WPxyz-moon/ESP32HandledConsole/docs/README.md

# 基于 ESP32-S3 的多模态 AI 游戏掌机 — 设计文档

> 版本：v0.1（方案设计稿）  
> 日期：2026-11-03  
> 依据：《手柄实现方案.docx》《选题申请表-周二下午-基于ESP32-S3游戏掌机.docx》  
> 参考项目：[OSHWHub / zistar / ESP32S3多功能手柄](https://oshwhub.com/zistar/project_fhhysqix)、[GitHub / zistar001 / ESP-Handheld](https://github.com/zistar001/ESP-Handheld)

## 文档索引

| 文档 | 内容 | 适合谁看 |
|---|---|---|
| [01-系统框图.md](01-系统框图.md) | 总体架构、硬件框图、软件分层、Flash 分区、引脚分配、关键设计决策 | 全员；硬件与系统负责人重点看 |
| [02-子系统流程图.md](02-子系统流程图.md) | 主系统、AI 子系统、游戏子系统的启动流程、状态机、时序与异常处理 | 软件负责人；联调时对照 |
| [03-项目实现计划.md](03-项目实现计划.md) | 第 5–14 周里程碑、任务分解、三人分工、测试指标、风险与交付物 | 组长与全员 |
| [04-参考项目分析.md](04-参考项目分析.md) | 参考项目拆解、可复用模块、改造点、许可证与已知坑 | 技术负责人；动手前必读 |
| [05-PCB核对与改板建议.md](05-PCB核对与改板建议.md) | 实际 PCB 引脚表、电源树、与参考项目差异、电池采样/保护等硬件风险 | 硬件与系统负责人；焊接/点屏前必读 |

## 一句话架构

**一颗 ESP32-S3 + 三套独立固件**：`factory` 主系统负责菜单、设置、BLE HID、Wi-Fi 音频与电源管理；`ota_0` 游戏系统运行 Retro-Go / nofrendo NES 模拟器；`ota_1` AI 系统运行文本对话、语音对话与图形化 AI 宠物。三套固件通过 `otadata` 切换，切换时重启并清空 RAM，从机制上避免长期运行后的内存碎片与 OOM。

```text
                    ┌──────────────────────────────┐
                    │        ESP32-S3 (N16R8)      │
                    │  8MB PSRAM / 16MB Flash      │
                    │  Wi-Fi 2.4G / BLE 5.0        │
                    └──────────────┬───────────────┘
                                   │
          ┌────────────────────────┼────────────────────────┐
          │                        │                        │
   ┌──────▼──────┐          ┌──────▼──────┐          ┌──────▼──────┐
   │  factory    │          │    ota_0    │          │    ota_1    │
   │  主系统     │          │  游戏系统   │          │  AI 系统    │
   │ 菜单/设置   │          │ Retro-Go    │          │ 文本/语音   │
   │ BLE/Wi-Fi   │          │ NES 模拟器  │          │ AI 宠物     │
   └─────────────┘          └─────────────┘          └─────────────┘
```

## 硬件前提（开工前先确认）

本方案按 **ESP32-S3-WROOM-1U-N16R8（8MB Octal PSRAM + 16MB Flash）** 设计。项目内已有实际 PCB：`Gerber_PCB1_2026-10-27/`；**引脚与连接以该文件夹的数据文件（Gerber / `FlyingProbeTesting.json`）为准**，`硬件设计参考图.png` 只作辅助参考。完整核对见 [05-PCB核对与改板建议.md](05-PCB核对与改板建议.md)。

- [x] 模组：`ESP32-S3-WROOM-1U-N16R8`，16MB Flash / 8MB Octal PSRAM
- [x] 屏幕：ST7789 240×280 SPI（1.69 寸）
- [x] 音频：MSM261 数字麦克风 + MAX98357 数字功放
- [x] 传感器：LSM6DS3TR-C 六轴 IMU
- [x] 存储：microSD（SPI3）
- [x] 按键：8 键，含独立 CTRL（GPIO8）
- [ ] 电池：**必须使用自带保护板的 3.7V 锂电池**（PCB 只有 TP4056 充电，无过放保护）
- [ ] 电量采样：**当前 PCB 无 BAT_ADC / 电量计**，需外挂 I2C 电量计（MAX17048/ADS1115）或改板
- [ ] 充电状态：**TP4056 的 CHRG/STDBY 只接 LED，没有接到 MCU**；软件要显示充电状态需额外引出/电平转换
- [ ] 天线：1U 模组必须外接 IPEX 2.4G 天线

> **重要**：当前 PCB 没有电池电压采样。未补装电量计前，“电量百分比、低电保护、电量误差 <5%”无法验收。处理方案见 [05 §6](05-PCB核对与改板建议.md#p0-1--没有电池电压采样--电量计)。
>
> 如果手上是经典 ESP32（非 S3）或没有 8MB PSRAM，本方案的“三固件 + LVGL + NES + 语音”需要降级：优先保留单固件主系统 + NES，AI 与三固件作为选做。具体裁剪见 [03-项目实现计划.md](03-项目实现计划.md)。

## 方案边界

**要做**：LVGL 图形界面、NES 模拟器、AI 文本助手、图形化 AI 宠物（按键/重力/语音）、Wi-Fi 音频、BLE 键盘/手柄、三固件切换、电源管理、数字音频系统、Ctrl 键与键盘映射。

**不做**（按《手柄实现方案》）：天气、占卜、频谱分析仪；参考项目中的音乐/视频播放器也不在本次范围。

## 需求覆盖矩阵

| 《手柄实现方案》要求 | 落地位置 |
|---|---|
| NES 模拟器 | [02-子系统流程图 §3](02-子系统流程图.md#3-游戏子系统ota_0) |
| AI 语言助手（文本输入） | [02-子系统流程图 §2.2](02-子系统流程图.md#22-文本对话时序) |
| 图形化 AI 小助手（按键/重力/音频） | [02-子系统流程图 §2.4–2.5](02-子系统流程图.md#24-图形化-ai-宠物状态机) |
| Wi-Fi 音频（语音传主机） | [01-系统框图 §6](01-系统框图.md#6-关键数据流) |
| 游戏下载 | [02-子系统流程图 §1.6](02-子系统流程图.md#16-wi-fi-游戏资源下载) |
| LVGL 图形界面 | [01-系统框图 §3](01-系统框图.md#3-软件分层框图) |
| 三固件切换 | [01-系统框图 §4](01-系统框图.md#4-flash-分区与三固件切换) |
| 电源管理（电量/低电保护） | [01-系统框图 §7.6](01-系统框图.md#76-电源与低电保护依赖外挂电量计) / [05 §6](05-PCB核对与改板建议.md#p0-1--没有电池电压采样--电量计) |
| 音频系统（数字麦/功放） | [01-系统框图 §5.3](01-系统框图.md#53-音频i2s) |
| 键盘（Ctrl + 方向键映射） | [01-系统框图 §7.3](01-系统框图.md#73-键盘映射) |
| BLE 蓝牙手柄 | [02-子系统流程图 §1.5](02-子系统流程图.md#15-主系统功能入口) |
| 性能/成本指标 | [03-项目实现计划 §3 第14周](03-项目实现计划.md#第-14-周联调与验收) |

## 阅读顺序建议

1. 先看 [05-PCB核对与改板建议.md](05-PCB核对与改板建议.md)，确认实际引脚、电源与电池采样风险。
2. 再看 [04-参考项目分析.md](04-参考项目分析.md) 了解参考项目能给我们什么、不能照搬什么。
3. 再看 [01-系统框图.md](01-系统框图.md) 确认硬件接口与分区。
4. 软件同学看 [02-子系统流程图.md](02-子系统流程图.md) 认领模块。
5. 最后按 [03-项目实现计划.md](03-项目实现计划.md) 排期与验收。

## 文档约定

- 图中的引脚编号以 `Gerber_PCB1_2026-10-27/` 的实际数据文件为准；`硬件设计参考图.png` 仅辅助理解，不作为连接依据。参考项目 Rev2 的分配只用于解释“为什么这样改”。
- 所有流程图使用 Mermaid 编写，GitHub、GitLab、支持 Mermaid 的 Markdown 预览可直接渲染。VS Code 若看不到图，可安装 “Markdown Preview Mermaid Support” 扩展，或把文档推到 GitHub 查看。
- 图中“主系统 / 游戏系统 / AI 系统”均指独立固件，不是同一固件内的三个页面。
