WPxyz-moon/ESP32HandledConsole/docs/01-系统框图.md

# 01 · 系统框图

> 对应《手柄实现方案》与《选题申请表》中的“系统总体方案与硬件设计”“双固件分区规划”。  
> 目标：在单块 ESP32-S3 上，用三套独立固件承载主系统、游戏系统与 AI 系统，并共用一套板级驱动源码。

> **硬件基线（2026-11-03 更新）**：本文引脚以 `Gerber_PCB1_2026-10-27/` 的实际数据文件为准，模组为 `ESP32-S3-WROOM-1U-N16R8`。完整核对、差异与风险见 [05-PCB核对与改板建议.md](05-PCB核对与改板建议.md)。当前 PCB **没有电池电压采样/电量计**，电量显示与低电保护需外挂 I2C 电量计或改板后才能验收。

## 1. 设计目标

| 维度 | 目标 |
|---|---|
| 主控 | ESP32-S3-WROOM-1U-N16R8，双核 Xtensa LX7，最高 240 MHz |
| 存储 | 8MB Octal PSRAM + 16MB Flash |
| 显示 | ST7789 240×280 SPI 彩屏，LVGL v8.4 |
| 输入 | 8 键：UP / DOWN / LEFT / RIGHT / A / B / START / CTRL（CTRL=GPIO8） |
| 音频 | MSM261 数字麦克风（I2S RX）+ MAX98357 数字功放（I2S TX） |
| 传感 | LSM6DS3TR-C 六轴 IMU；AHT20 温湿度（可选，需外挂） |
| 存储 | microSD（ROM / 资源 / 存档，SPI3；无卡检测脚） |
| 无线 | Wi-Fi 2.4GHz（云端 AI、UDP 音频、资源下载）；BLE 5.0（HID 键盘/手柄） |
| 电源 | 带保护板锂电池 + TP4056 充电 + 自动切换 + SY8088 3.3V；**电量采样待补** |
| 系统形态 | `factory` 主系统 / `ota_0` 游戏 / `ota_1` AI，三固件切换 |

## 2. 总体系统框图

系统框图

> 可编辑的矢量图源文件：[系统框图.svg](系统框图.svg)；如需插入 Word/PPT，可用同目录下的 [系统框图.png](系统框图.png)。下图是同一结构的 Mermaid 版本，便于在 GitHub 上直接查看与修改。

```mermaid
flowchart LR
    subgraph PWR["电源子系统"]
        USB["USB-C 5V 输入"]
        CHG["TP4056 充电<br/>（无过放保护）"]
        BAT["3.7V 锂电池<br/>（带保护板）"]
        REG["SY8088 3.3V 降压"]
        GAUGE["I2C 电量计 / ADC<br/>（待补）"]
        USB --> CHG
        CHG <--> BAT
        BAT --> REG
        BAT -.-> GAUGE
    end

    subgraph MCU["ESP32-S3-WROOM-1U-N16R8"]
        CPU["双核 Xtensa LX7<br/>最高 240 MHz"]
        MEM["8 MB Octal PSRAM<br/>16 MB Flash"]
        RF["2.4 GHz Wi-Fi<br/>Bluetooth LE 5.0"]
        IO["SPI / I2S / I2C<br/>GPIO / ADC / PWM"]
        CPU --- MEM
        CPU --- RF
        CPU --- IO
    end

    subgraph HMI["人机交互"]
        LCD["ST7789 240×280<br/>CS42/DC43/BL44"]
        BL["背光 PWM<br/>GPIO44"]
        KEY["8 个按键<br/>UP/DOWN/LEFT/RIGHT<br/>A/B/START/CTRL(8)"]
        IMU["LSM6DS3TR-C<br/>六轴 IMU（无 INT）"]
        AHT["AHT20 温湿度<br/>可选外挂"]
    end

    subgraph AUDIO["音频子系统"]
        MIC["MSM261<br/>I2S 数字麦克风"]
        AMP["MAX98357<br/>I2S 数字功放"]
        SPK["扬声器"]
    end

    subgraph STORAGE["存储"]
        SD["microSD 卡<br/>SPI3（CS38/CLK40）"]
        FLASH["Flash 分区<br/>factory / ota_0 / ota_1 / assets"]
    end

    subgraph CLOUD["网络与上位机"]
        PC["PC / 手机"]
        API["云端 ASR / LLM / TTS"]
    end

    REG -->|"3.3V"| CPU
    GAUGE -.->|"I2C（待补）"| IO
    USB -.->|"USB Serial/JTAG"| CPU
    IO -->|"SPI2 + DMA"| LCD
    IO -->|"PWM"| BL
    KEY -->|"GPIO 中断"| IO
    IMU <-->|"I2C"| IO
    AHT <-->|"I2C"| IO
    MIC -->|"I2S0 RX"| IO
    IO -->|"I2S1 TX"| AMP
    AMP --> SPK
    SD <-->|"SPI3"| IO
    MEM --- FLASH
    RF <-->|"Wi-Fi / HTTPS / WebSocket"| API
    RF <-->|"BLE HID"| PC
    RF <-->|"Wi-Fi UDP"| PC
```

### 框图说明

- **显示与 SD 卡分总线**：ST7789 走 `SPI2_HOST`，SD 卡走 `SPI3_HOST`，避免屏幕 DMA 刷新被 SD 读写阻塞。
- **音频双 I2S**：麦克风走 `I2S0`（RX），功放走 `I2S1`（TX），可同时录音与播放，便于语音对话和“打断”。
- **按键独立 GPIO**：8 个按键全部用 GPIO 上拉 + 低有效，按下产生中断，软件 10–20ms 消抖；CTRL 独立接 GPIO8，不做长按复用。
- **电源采样（待补）**：当前 PCB 没有 BAT_ADC/电量计，TP4056 的 CHRG/STDBY 也只接 LED、没有接到 MCU。需在 I2C 总线上外挂 MAX17048 或 ADS1115+分压，才能做电量显示与低电保护；未补装前只能做运行时间估算。详见 [05 §6](05-PCB核对与改板建议.md#p0-1--没有电池电压采样--电量计)。
- **无线分时**：BLE HID 与 Wi-Fi 不同时高负载使用；游戏手柄模式以 BLE 为主，Wi-Fi 音频模式以 Wi-Fi 为主。
- **显示引脚注意**：本板 `LCD_DC=GPIO43`、`LCD_BL=GPIO44`，与参考项目 Rev2 的 44/43 相反；固件不要照抄参考。

## 3. 软件分层框图

三套固件是**三个独立二进制**，但共享同一套 BSP 与驱动源码，避免重复造轮子。

```mermaid
flowchart TB
    subgraph APP["应用层（三套固件各自实现）"]
        M["主系统<br/>菜单 / 设置 / BLE HID<br/>Wi-Fi 音频 / 文本 AI 入口"]
        A["AI 系统<br/>文本对话 / 语音对话<br/>图形化 AI 宠物"]
        G["游戏系统<br/>Retro-Go / nofrendo NES"]
    end

    subgraph FRAME["框架层（源码复用）"]
        AM["App Manager / Launcher / 状态机"]
        UI["LVGL v8.4 / 主题 / 中文字体"]
        SVC["设置 NVS / 事件分发 / 电源管理"]
        NET["Wi-Fi Manager / BLE HID<br/>HTTP / WebSocket / UDP"]
    end

    subgraph BSP["BSP 板级支持层（源码复用）"]
        LCDD["ST7789 + DMA 双缓冲"]
        KEYD["按键扫描与消抖"]
        AUDD["I2S 麦克风 / 功放"]
        SENS["IMU / 电量计（I2C）<br/>AHT20 可选外挂"]
        STOD["SD 卡 / Flash 分区 / OTA"]
    end

    subgraph SYS["系统层"]
        IDF["ESP-IDF v5.x + FreeRTOS"]
        HW["ESP32-S3 硬件"]
    end

    APP --> FRAME
    FRAME --> BSP
    BSP --> SYS
```

> 注意：这里的“复用”是**源码级复用**，不是三套固件同时运行。任一时刻只有一个固件在跑，另外两套在 Flash 里休眠。

### 任务划分（主系统示例）

| 任务 | 优先级 | 栈建议 | 职责 |
|---|---|---|---|
| `lvgl_task` | 中 | 8–12KB | LVGL 刷新、界面事件、动画 |
| `key_task` | 中高 | 3–4KB | 按键扫描、消抖、组合键识别 |
| `audio_task` | 高 | 4–6KB | I2S 录音/播放、环形缓冲 |
| `net_task` | 低 | 6–8KB | Wi-Fi 连接、HTTP/WebSocket、UDP |
| `power_task` | 低 | 3KB | 电量计（I2C）/ADC 采样、低电保护、休眠 |
| `app_task` | 中 | 6–8KB | 当前应用主循环、状态切换 |

> 具体优先级按实测调整；音频与屏幕 DMA 相关任务优先级应高于网络与 UI 动画。

## 4. Flash 分区与三固件切换

### 4.1 16MB Flash 分区表

| 分区 | 偏移 | 大小 | 内容 | 说明 |
|---|---|---|---|---|
| `nvs` | `0x9000` | 16KB | 设置、Wi-Fi、主题、API Key | 三套固件共享 |
| `otadata` | `0xD000` | 8KB | 启动分区选择 | 切换固件的关键 |
| `phy_init` | `0xF000` | 4KB | RF 校准 | 固定 |
| `factory` | `0x10000` | 4MB | 主系统 | 默认启动 |
| `ota_0` | `0x410000` | 4MB | 游戏系统（Retro-Go） | 菜单切换 |
| `ota_1` | `0x810000` | 4MB | AI 系统 | 菜单切换 |
| `assets` | `0xC10000` | 约 3.94MB（剩余空间） | SPIFFS 资源 | 字体、表情、音效 |

> 如果 Flash 只有 8MB，无法放下三个 4MB 应用分区。此时建议：`factory` 4MB + `ota_0` 3MB + `assets` 1MB，取消独立 AI 固件，AI 作为主系统内的一个应用（功能与稳定性都会下降）。

### 4.2 切换机制

```mermaid
flowchart LR
    A["当前固件"] -->|"菜单选择 / 组合键"| B["保存设置与存档"]
    B --> C["esp_ota_set_boot_partition(目标)"]
    C --> D["esp_restart()"]
    D --> E["Bootloader 读取 otadata"]
    E --> F["启动目标分区"]
    F --> G["重新初始化<br/>RAM 全部清空"]
```

**为什么必须重启**：ESP-IDF 的 `esp_ota_set_boot_partition()` 只改变下次启动分区，不会释放当前堆。重启后 Bootloader 重新建立堆与任务，才能彻底清空 RAM，达到“消灭内存碎片”的目的。

**回退策略**：

- `otadata` 无效或目标分区校验失败 → Bootloader 回退 `factory`。
- 子固件启动后 10 秒内未收到“健康心跳” → 主系统下次启动时清除切换标志（可选增强）。
- 任何子固件内按住 `START + B` 1.5 秒 → 切回 `factory`。

## 5. 硬件接口与引脚分配（实际 PCB）

> 下表来自 `Gerber_PCB1_2026-10-27/FlyingProbeTesting.json` 的 U3 网络表，按 `ESP32-S3-WROOM-1U` 标准引脚序换算。**PCB 设计以该文件夹的数据文件为准，`硬件设计参考图.png` 仅辅助。** 与参考项目不同的项已用粗体标出；完整表与风险见 [05-PCB核对与改板建议.md](05-PCB核对与改板建议.md)。

### 5.1 显示（SPI2）

| 信号 | 实际 GPIO | 说明 |
|---|---|---|
| LCD_SCK | GPIO21 | SPI 时钟 |
| LCD_MOSI | GPIO14 | SPI 数据 |
| LCD_CS | GPIO42 | 片选 |
| LCD_DC | **GPIO43** | 数据/命令；参考项目为 GPIO44，**不要照抄** |
| LCD_RST | GPIO13 | 复位 |
| LCD_BL | **GPIO44** | 背光 PWM；参考项目为 GPIO43，**不要照抄** |

> 背光 Q2 基极有 10k 上拉到 3V3，**上电默认常亮**；固件应尽早把 GPIO44 拉低，LCD 初始化完成后再 PWM 点亮。

### 5.2 SD 卡（SPI3）

| 信号 | 实际 GPIO | 说明 |
|---|---|---|
| SD_CS | GPIO38 | 片选 |
| SD_CLK | GPIO40 | 时钟 |
| SD_MOSI | GPIO39 | 数据 |
| SD_MISO | GPIO41 | 数据 |

> J1 的卡检测脚（1/8）未连接，**没有 CD 信号**；固件只能挂载失败重试，不能依赖热插拔中断。

### 5.3 音频（I2S）

| 信号 | 实际 GPIO | 说明 |
|---|---|---|
| MIC_BCLK | GPIO11 | MSM261 位时钟（I2S0） |
| MIC_WS | GPIO12 | MSM261 字选择（I2S0） |
| MIC_DATA | GPIO10 | MSM261 数据（I2S0） |
| AMP_BCLK | GPIO46 | MAX98357 位时钟（I2S1） |
| AMP_LRC | GPIO9 | MAX98357 左右声道时钟（I2S1） |
| AMP_DIN | GPIO3 | MAX98357 数据（I2S1） |

### 5.4 I2C 传感器

| 信号 | 实际 GPIO | 说明 |
|---|---|---|
| I2C_SDA | GPIO1 | IMU（以及可外挂的电量计/ADC） |
| I2C_SCL | GPIO2 | IMU（以及可外挂的电量计/ADC） |

| 器件 | 地址 | 说明 |
|---|---|---|
| LSM6DS3TR-C | `0x6A` | 六轴 IMU，SA0 接 VDD；**INT1/INT2 未连接，只能轮询** |
| AHT20 | `0x38` | 温湿度，**PCB 未设计**，需要时外挂 |
| MAX17048（建议） | `0x36` | 电量计，外挂到 I2C |
| ADS1115（备选） | `0x48` | 16 位 ADC + 分压，外挂到 I2C |

### 5.5 按键

| 按键 | 实际 GPIO | 功能 |
|---|---|---|
| UP | GPIO16 | 上 / 音量+ |
| DOWN | GPIO15 | 下 / 音量− |
| LEFT | GPIO17 | 左 |
| RIGHT | GPIO7 | 右 / Wi-Fi 音频 PTT |
| A | GPIO4 | 确认 / 游戏 A / AI 说话 |
| B | GPIO5 | 返回 / 游戏 B |
| START | GPIO6 | 菜单 / 游戏开始 |
| CTRL | **GPIO8** | 键盘修饰键；**PCB 已设计独立第 8 键**，无需长按复用 |

### 5.6 其他

| 信号 | 实际 GPIO | 说明 |
|---|---|---|
| BAT_ADC | **未连接** | 当前 PCB 无分压/电量计；需外挂 I2C 电量计或改板 |
| LED | GPIO18 | 用户指示灯（LED_G3，**低电平点亮**） |
| BOOT | GPIO0 | 下载模式（SW2） |
| RESET | EN | 复位键（SW3） |
| USB D-/D+ | GPIO19 / GPIO20 | 原生 USB Serial/JTAG；无 CH340/CP2102 |
| 天线 | IPEX | 1U 模组必须外接 2.4G FPC 天线 |

> **引脚复核清单**：GPIO0/3/45/46 为 Strapping 引脚；N16R8 的 Octal PSRAM 占用 GPIO35–37，PCB 已将这些脚悬空（NET_14/15/16），不要再改作他用。GPIO39–42 默认是 JTAG，现被 SD/LCD 占用，调试统一走 USB Serial/JTAG。GPIO43/44 默认是 UART0，现被 LCD 占用，不要再用 UART0 打日志。

### 5.7 与参考项目的关键差异

| 项 | 参考项目 Rev2 | 本板实际 | 处理 |
|---|---|---|---|
| 模组 | ESP32-S3 N16R8 | `ESP32-S3-WROOM-1U-N16R8` | 1U 必须外接天线 |
| CTRL | 无（7 键） | GPIO8（8 键） | 固件增加 `BSP_KEY_CTRL` |
| LCD_DC | GPIO44 | **GPIO43** | 固件改引脚 |
| LCD_BL | GPIO43 | **GPIO44** | 固件改引脚 |
| 电池 ADC | 无 | **无** | 外挂 I2C 电量计或改板 |
| SD 卡检测 | 无 | **无** | 挂载失败重试 |
| IMU 中断 | 未接 | **未接** | 定时轮询 |
| AHT20 | 有 | **无** | 可选外挂 |

## 6. 关键数据流

| 数据流 | 路径 | 关键点 |
|---|---|---|
| 游戏画面 | nofrendo 帧缓冲 → RGB565 → SPI2 DMA → ST7789 | PSRAM 帧缓冲 + 内部 DMA  bounce buffer |
| 游戏音频 | APU → 环形缓冲 → I2S1 → MAX98357 | 缓冲 2–3 帧，防欠载 |
| 语音上行 | MSM261 → I2S0 → PCM 环形缓冲 → Opus → Wi-Fi → 云端/PC | 16kHz / 16bit / 单声道 |
| 语音下行 | 云端 TTS / PC → Opus → I2S1 → MAX98357 | 24kHz 或 16kHz，按服务端返回 |
| AI 文本 | LVGL 键盘 → UTF-8 → HTTPS JSON → 流式响应 → LVGL | 分块显示，避免一次性大缓冲 |
| BLE HID | 按键扫描 → HID report → GATT Notify → PC/手机 | 键盘与手柄两种 report |
| Wi-Fi 音频 | MSM261 → PCM → UDP → PC 接收端 | 局域网，目标端到端 <300ms |
| 游戏下载 | PC/云端 HTTP → SD 卡 `/roms/nes` | 断点/校验后刷新游戏列表 |
| 固件切换 | 菜单 → `esp_ota_set_boot_partition()` → `esp_restart()` | 先保存设置/存档 |

## 7. 关键设计决策

### 7.1 三固件而不是单固件多页面

| 方案 | 优点 | 缺点 | 结论 |
|---|---|---|---|
| 单固件多页面 | 切换快、共享内存 | LVGL + NES + 语音 + 网络长期运行易碎片化/OOM | 不采用 |
| 三固件分区 | 每次切换清空 RAM；故障隔离；可独立编译 | 每次切换重启 3–5 秒；Flash 占用 12MB | **采用** |

### 7.2 8 键与 CTRL 的实现（PCB 已定）

《手柄实现方案》要求“在原来上下左右 AB 的基础上加一个 CTRL”。**实际 PCB 已经增加第 8 个按键，独立接 GPIO8**，因此直接采用方案 1：

1. **独立 CTRL 键（已落地）**：`BSP_KEY_CTRL = GPIO8`，组合键识别最干净，不需要长按复用。
2. **长按 START 复用（仅作历史备选）**：如果后续改板砍掉第 8 键，才需要长按 START ≥300ms 进入“CTRL 修饰”。本板不需要。

> 注意：GPIO8 同时是 ADC1_CH7。如果以后要给电池加 ADC 分压，可以把 CTRL 改到 GPIO47（当前悬空），把 GPIO8 让给 BAT_ADC；这是改板/飞线方案，详见 [05 §6](05-PCB核对与改板建议.md#p0-1--没有电池电压采样--电量计)。

### 7.3 键盘映射

| 模式 | 按键 | HID 输出 |
|---|---|---|
| 键盘 | A | `Enter` |
| 键盘 | B | `Backspace` |
| 键盘 | START | `Esc` |
| 键盘 | CTRL + LEFT | `Ctrl + A`（全选） |
| 键盘 | CTRL + RIGHT | `Ctrl + X`（剪切） |
| 键盘 | CTRL + UP | `Ctrl + V`（粘贴） |
| 键盘 | CTRL + DOWN | `Ctrl + C`（复制） |
| 键盘 | 方向键 | 方向键 |
| 手柄 | A/B/方向/START | HID Gamepad 对应按钮 |
| 手柄 | IMU（可选） | 倾斜映射为摇杆/视角 |

> 这是按《手柄实现方案》的约定，不是 PC 通用快捷键。若使用者更习惯标准快捷键，可在设置里提供“方向键映射”与“标准 Ctrl 映射”两套配置。

### 7.4 AI 放在独立固件

主系统只保留“AI 助手”入口，点击后切到 `ota_1`。原因：

- AI 需要 Wi-Fi + 音频 + 编解码 + LVGL 动画，堆占用大；
- 与游戏、主系统隔离，避免 AI 网络异常拖垮主系统；
- 切换重启后 RAM 干净，语音缓冲更容易分配。

### 7.5 屏幕与 NES 分辨率的适配

- ST7789 玻璃可视区 240×280，控制器显存 240×320，初始化需设置 `Y offset = 20`。
- NES 原生 256×240。优先**等比缩放 + 左右裁切**到 240×240，上下留 20px 状态栏/黑边；也可整屏拉伸到 240×280，但像素会略变形。
- 缩放用最近邻，避免双线性带来的额外 CPU 开销。

### 7.6 电源与低电保护（依赖外挂电量计）

**当前 PCB 没有 BAT_ADC / 电量计**（参考项目源码也明确注释“无 ADC 检测”），TP4056 的 CHRG/STDBY 也只接 LED、没有接到 MCU。因此下表的电量百分比与电压阈值，只有在补装 I2C 电量计（MAX17048/ADS1115）或改板后才能成立。未补装前，固件既不能显示电量百分比，也不能由软件判断充电状态，只能做运行时间估算；不能验收“电量误差 <5%”和低电保护。

| 阈值 | 动作 |
|---|---|
| 电量 ≤ 20% | 状态栏变红，提示充电（需电量计） |
| 电压 < 3.4V | 降低背光至 30%，关闭 Wi-Fi/BLE（需电量计/ADC） |
| 电压 < 3.3V | 保存设置/存档，进入 Light Sleep 或提示关机（需电量计/ADC） |
| 空闲 30s | 背光降到 50% |
| 空闲 60s | Light Sleep，任意按键唤醒 |

> 推荐补装：MAX17048（I2C `0x36`，直接算 SOC）或 ADS1115（I2C `0x48` + 100k/100k 分压）。接线与精度说明见 [05 §6](05-PCB核对与改板建议.md#p0-1--没有电池电压采样--电量计)。

> 参考项目的休眠存在“睡死唤不醒”的已知问题。本项目必须单独验证 `gpio_wakeup_enable()` + `esp_light_sleep_start()` 的唤醒路径，并在第 13 周做 100 次睡眠/唤醒循环测试。

## 8. 与参考项目的对应关系

| 本方案模块 | 参考项目对应 | 复用方式 |
|---|---|---|
| 主系统框架 | `main/app` + `main/ui` + `main/modules` | 复用架构，删减天气/占卜/频谱 |
| 显示与按键 | `main/bsp/st7789_driver.c`、`key_driver.h` | 改引脚后复用 |
| 音频 | `main/modules/audio` | 复用 I2S 配置，改采样率/增益 |
| BLE HID | `main/modules/pc_remote/ble_hid.c` | 复用，增加 Ctrl 映射 |
| Wi-Fi 音频 | `main/modules/pc_remote/wifi_audio.c` | 复用 UDP 方案 |
| 游戏系统 | `retro-go-firmware/` + `components/retro-go` | 复用 Retro-Go 与 nofrendo |
| AI 系统 | `xiaozhi-zistar-main/` | 复用板级配置与语音链路，增加宠物界面 |
| 分区与切换 | `partitions.csv` + 菜单切换逻辑 | 复用三分区布局 |
| PCB 引脚 | `Gerber_PCB1_2026-10-27/` | **以实际数据文件为准**；LCD DC/BL 与参考相反，CTRL=GPIO8，无电池 ADC |

详细拆解见 [04-参考项目分析.md](04-参考项目分析.md) 与 [05-PCB核对与改板建议.md](05-PCB核对与改板建议.md)。
