WPxyz-moon/ESP32HandledConsole/docs/02-子系统流程图.md

# 02 · 子系统流程图

> 本文把设备拆成三个独立固件子系统：**主系统（factory）**、**AI 系统（ota_1）**、**游戏系统（ota_0）**。  
> 每个子系统给出启动流程、核心状态机/时序、异常处理。图中的按键约定见第 4 节。

## 0. 阅读说明

- 三套固件共享 BSP 与驱动源码，但**不同时运行**；任一时刻只有一个固件占用 CPU、RAM 与外设。
- 所有“切回主系统”的动作，最终都是 `esp_ota_set_boot_partition(factory)` + `esp_restart()`。
- 图中的超时、阈值都是首版默认值，联调时按实测调整。

---

## 1. 主系统（factory）

主系统负责：开机、菜单、设置、电源管理、BLE HID、Wi-Fi 音频、AI/游戏入口、文件与资源管理。

### 1.1 启动流程

```mermaid
flowchart TD
    S(["上电 / 复位"]) --> BL["Bootloader"]
    BL --> OT{"读取 otadata"}
    OT -->|"factory / 无效"| M["启动主系统固件"]
    OT -->|"ota_0"| G["启动游戏固件"]
    OT -->|"ota_1"| A["启动 AI 固件"]

    M --> N["初始化 NVS<br/>加载设置 / 主题 / Wi-Fi 凭据"]
    N --> B["BSP 初始化<br/>电源、GPIO、I2C、SPI、I2S、电量计"]
    B --> L["ST7789 初始化 + LVGL 初始化"]
    L --> P["按键 / IMU / 电池采样 / 音频"]
    P --> SD["挂载 microSD（失败则跳过）"]
    SD --> W["异步启动 Wi-Fi Manager 与 BLE HID"]
    W --> UI["显示 Launcher 与状态栏"]
    UI --> E["事件循环<br/>按键 / LVGL / 定时器 / 电源"]
    E --> SEL{"用户选择"}
    SEL -->|"游戏"| SW1["保存设置 → 切 ota_0 → 重启"]
    SEL -->|"AI 助手"| SW2["保存设置 → 切 ota_1 → 重启"]
    SEL -->|"设置 / 文件 / 电源"| APP["进入对应应用"]
    APP --> E
```

**启动顺序的硬性要求**：

1. 先初始化 NVS，再读设置；否则亮度、音量、主题会丢。
2. 先初始化电源与 GPIO，再初始化屏幕；本板背光电路有 10k 上拉，**上电默认常亮**，应尽早把 GPIO44 拉低，屏幕初始化完成后再 PWM 点亮，避免开机白屏/闪白。
3. Wi-Fi 与 BLE 必须**异步**启动，不能阻塞 Launcher 显示；否则开机黑屏 3–5 秒。
4. 按键中断在系统初始化完成前不处理，防止初始化期间误触导致重启（参考项目踩过这个坑）。

### 1.2 应用状态机

```mermaid
stateDiagram-v2
    [*] --> Launcher
    Launcher --> Menu: START
    Menu --> Launcher: B / START
    Menu --> Running: A
    Running --> Menu: B / START
    Running --> Launcher: 长按 START
    state Running {
        [*] --> AppInit
        AppInit --> AppLoop
        AppLoop --> AppExit: 退出
        AppExit --> [*]
    }
```

| 状态 | 界面 | 按键行为 |
|---|---|---|
| `Launcher` | 主屏：时间、电量、Wi-Fi、应用卡片 | 方向键切换卡片；A 进入；START 打开菜单 |
| `Menu` | 应用网格：游戏、AI、设置、文件、电源 | 方向键导航；A 确认；B/START 返回 |
| `Running` | 当前应用界面 | 由应用自己处理；B/START 返回菜单 |

### 1.3 固件切换时序

```mermaid
sequenceDiagram
    autonumber
    participant U as 用户
    participant APP as 当前固件
    participant OTA as esp_ota
    participant BL as Bootloader
    participant TGT as 目标固件

    U->>APP: 菜单选择“游戏”/“AI”<br/>或按住 START+B
    APP->>APP: 保存设置 / 游戏存档 / 关闭外设
    APP->>OTA: esp_ota_set_boot_partition(目标分区)
    OTA-->>APP: ESP_OK
    APP->>APP: esp_restart()
    APP->>BL: 芯片复位
    BL->>BL: 读取 otadata，校验目标分区
    alt 目标分区有效
        BL->>TGT: 启动目标固件
        TGT->>TGT: 重新初始化，RAM 清空
    else 目标分区无效
        BL->>APP: 回退 factory
    end
```

**切换前必须做的事**：

- 保存音量、亮度、主题、Wi-Fi 凭据到 NVS。
- 游戏系统保存 SRAM/存档到 SD；AI 系统保存对话摘要与宠物状态。
- 关闭 I2S、DMA、Wi-Fi/BLE，避免重启瞬间的爆音或 Flash 写冲突。

### 1.4 电源管理流程

```mermaid
flowchart TD
    A["每 1 s 读电量计（I2C）<br/>或 BAT_ADC（改板后）"] --> B["滑动平均 + 电压/电量换算"]
    B --> C["计算电量百分比<br/>（充电状态需额外引出）"]
    C --> D["更新状态栏 / 低电图标"]
    D --> E{"电压 < 3.4 V ?"}
    E -->|"否"| F{"空闲时间"}
    E -->|"是"| G["低电提醒<br/>背光 30% / 关闭 Wi-Fi 与 BLE"]
    G --> H{"电压 < 3.3 V ?"}
    H -->|"是"| I["保存状态<br/>Light Sleep / 提示关机"]
    H -->|"否"| F
    F -->|"30 s"| J["背光降至 50%"]
    F -->|"60 s"| K["Light Sleep<br/>按键 GPIO 唤醒"]
    F -->|"活跃"| A
    J --> A
    K -->|"任意按键"| A
```

> **当前 PCB 前提**：`Gerber_PCB1_2026-10-27` 没有 BAT_ADC/电量计；TP4056 的 CHRG/STDBY 只接 LED，也没有接到 MCU。未补装 I2C 电量计（MAX17048/ADS1115）前，本节电量百分比、充电状态与低电压保护都无法实现；可先做运行时间估算，但不能作为验收。详见 [05-PCB核对与改板建议.md](05-PCB核对与改板建议.md#p0-1--没有电池电压采样--电量计)。

> **休眠验证**：参考项目存在“睡死唤不醒”的问题。本项目要求：
> 1. 只用 `gpio_wakeup_enable()` + `esp_light_sleep_start()`，不使用深睡作为默认路径；
> 2. 唤醒后重新初始化 I2S 与屏幕背光；
> 3. 第 13 周做 100 次睡眠/唤醒循环，成功率 100% 才验收。

### 1.5 主系统功能入口

| 入口 | 行为 | 依赖 |
|---|---|---|
| 游戏 | 切 `ota_0`，重启进 Retro-Go | SD 卡、分区表 |
| AI 助手 | 切 `ota_1`，重启进 AI 系统 | Wi-Fi（可选） |
| BLE 键盘 / 手柄 | 停留主系统，启动 BLE HID | BLE 协议栈 |
| Wi-Fi 音频 | 停留主系统，采集麦克风 → UDP → PC | Wi-Fi、PC 接收端 |
| 设置 | 音量、亮度、主题、按键映射、Wi-Fi 配网 | NVS |
| 文件 | 浏览 SD 卡、删除/复制 ROM 与资源 | SD 卡 |
| 游戏下载 | 通过 Wi-Fi 从 PC/云端下载 ROM 或资源到 SD | Wi-Fi、SD、HTTP |
| 电源 | 电量、休眠、关机（充电状态需额外引出） | 电量计（I2C）或改板后的 ADC |

### 1.6 Wi-Fi 游戏/资源下载

```mermaid
flowchart TD
    A["主系统 → 文件 / 下载"] --> B{"Wi-Fi 已连接？"}
    B -->|"否"| C["提示先配网"]
    C --> B
    B -->|"是"| D["输入或选择下载地址<br/>HTTP/HTTPS"]
    D --> E["HTTP GET<br/>Range 断点续传"]
    E --> F{"下载成功？"}
    F -->|"否"| G["提示错误 / 重试 / 保留临时文件"]
    G --> E
    F -->|"是"| H["校验大小 / 文件头<br/>写入 SD /roms/nes"]
    H --> I["刷新游戏列表<br/>显示新 ROM"]
```

> 首版只做“单文件下载 + 校验”，不做完整的应用商店。下载任务放在低优先级任务，显示进度条，允许取消；下载中不进入游戏系统，避免 SD 写冲突。

---

## 2. AI 子系统（ota_1）

AI 子系统负责：Wi-Fi/配网、文本对话、语音对话、图形化 AI 宠物、云端 ASR/LLM/TTS 接入。

### 2.1 启动与联网

```mermaid
flowchart TD
    S(["复位进入 ota_1"]) --> B["BSP 初始化<br/>LCD / 按键 / I2S / IMU / 电量计"]
    B --> L["LVGL + 中文字体 + 宠物表情资源"]
    L --> N["加载 NVS<br/>Wi-Fi、API Key、宠物配置"]
    N --> C{"Wi-Fi 已配置？"}
    C -->|"否"| P["SoftAP / BLE 配网"]
    P --> C
    C -->|"是"| W["连接 Wi-Fi<br/>超时 15 s"]
    W --> OK{"连接成功？"}
    OK -->|"否"| O["离线模式<br/>仅本地宠物互动 + 文本提示"]
    OK -->|"是"| H["云端健康检查<br/>/health 或握手"]
    H --> UI["AI 主页<br/>文本对话 / 语音对话 / AI 宠物"]
    O --> UI
    UI --> EXIT{"START+B 按住 1.5 s？"}
    EXIT -->|"是"| R["保存状态 → 切 factory → 重启"]
    EXIT -->|"否"| UI
```

**配网方式（二选一，首版建议都保留）**：

1. **SoftAP 配网**：设备开热点，手机连上后打开配置页填写 SSID/密码；实现简单，UI 可用 LVGL 显示二维码。
2. **BLE 配网**：手机 App 通过 BLE 写入 Wi-Fi 凭据；体验好，但开发量大。

> 参考项目使用 `esp-wifi-connect` 组件做配网，可直接复用其 SoftAP 流程。

### 2.2 文本对话时序

```mermaid
sequenceDiagram
    autonumber
    participant U as 用户
    participant UI as LVGL 界面
    participant APP as AI 应用
    participant NET as Wi-Fi / HTTPS
    participant CLOUD as 云端 LLM

    U->>UI: 屏幕键盘输入问题
    UI->>APP: UTF-8 文本（长度限制 512 字节）
    APP->>APP: 检查 Wi-Fi / API Key
    APP->>NET: POST /v1/chat（JSON，stream=true）
    NET->>CLOUD: HTTPS 请求
    CLOUD-->>NET: SSE / chunk 增量文本
    NET-->>APP: 逐块解析
    APP->>UI: 追加显示（自动滚动）
    APP->>APP: 保存最近 10 轮对话到 NVS
    APP-->>U: 完成 / 错误提示
```

**实现要点**：

- 输入框限制长度，避免 LVGL 文本控件与 JSON 缓冲过大。
- 使用流式响应（SSE 或 chunked），第一段文本到达即显示，降低“卡住”的感知。
- 超时 15 秒，失败重试 2 次（指数退避）；仍失败则提示“网络/服务不可用”。
- API Key 存 NVS，不写死在代码里；配网页面可修改。

### 2.3 语音对话时序

```mermaid
sequenceDiagram
    autonumber
    participant U as 用户
    participant APP as AI 应用
    participant MIC as MSM261 / I2S0
    participant NET as Wi-Fi / WebSocket
    participant CLOUD as 云端 ASR + LLM + TTS
    participant AMP as MAX98357 / I2S1

    U->>APP: 按住 A（PTT）
    APP->>MIC: 启动录音 16 kHz / 16 bit / 单声道
    MIC-->>APP: PCM 帧（20–40 ms/帧）
    APP->>APP: VAD / 静音检测 / Opus 编码
    APP->>NET: 二进制音频帧
    NET->>CLOUD: WebSocket 上行
    CLOUD-->>NET: ASR 文本 + LLM 回复 + TTS 音频
    NET-->>APP: Opus 下行 + 字幕文本
    APP->>AMP: 解码 PCM → I2S1 播放
    APP->>U: 字幕 / 宠物表情同步
    U->>APP: 松开 A / 再次按下打断
```

**协议选择**：

| 方案 | 优点 | 缺点 | 建议 |
|---|---|---|---|
| WebSocket 全双工 | 实现简单，浏览器/服务端都支持 | 延迟略高于 UDP | **首版采用** |
| MQTT + UDP | 参考 XiaoZhi 的方案，延迟低 | 服务端与 NAT 穿透复杂 | 进阶 |
| HTTP 分段上传 | 最简单 | 延迟高，不适合实时语音 | 不采用 |

**音频参数**：麦克风 16kHz/16bit；TTS 常见 24kHz，按服务端返回重采样到 I2S 支持的速率。Opus 编码优先，若服务端只收 PCM，则用 16kHz PCM + 压缩传输。

### 2.4 图形化 AI 宠物状态机

```mermaid
stateDiagram-v2
    [*] --> Idle
    Idle --> Listening: 按住 A / 唤醒词
    Listening --> Thinking: 松开 A / VAD 结束
    Thinking --> Speaking: 收到 TTS / 文本回复
    Speaking --> Idle: 播放完成
    Speaking --> Listening: 用户打断
    Idle --> Reacting: 摇晃 / 倾斜 / 翻转 / 按键
    Reacting --> Idle: 动画结束
    Idle --> Sleeping: 60 s 无操作
    Sleeping --> Idle: 任意按键 / 摇晃
    Thinking --> Error: 网络失败 / 超时
    Error --> Idle: 提示后回到待机
```

### 2.5 多模态输入映射

| 输入 | 检测方式 | 宠物反应 | 是否走云端 |
|---|---|---|---|
| A 短按 | 按下 < 300ms | 摸摸头 / 开心表情 + 音效 | 否 |
| A 长按 | 按下 ≥ 300ms | 进入 `Listening`，录音 | 是（语音） |
| B | 短按 | 返回 / 取消当前动作 | 否 |
| 摇晃 | IMU 加速度方差 > 阈值 | 眩晕 / 转圈动画 | 否 |
| 左/右倾斜 | IMU 姿态角 | 向左/右倾斜、贴边动画 | 否 |
| 屏幕朝下翻转 | IMU z 轴 | 睡觉 / 打呼音效 | 否 |
| 语音指令 | ASR 文本意图 | 按意图播放动作 + 语音回复 | 是 |
| 温湿度（可选） | AHT20 | “好热 / 好冷”环境评论 | 可选 |
| 低电 | 电量计（I2C） | 困倦 / 提醒充电 | 否 |

> 本地反应优先：按键、IMU 动作不依赖网络，保证断网也能玩；语音与文本才走云端。

### 2.6 AI 子系统异常与降级

| 场景 | 检测 | 处理 |
|---|---|---|
| Wi-Fi 未配置 | NVS 无凭据 | 进入配网页面，宠物待机可用 |
| Wi-Fi 连接失败 | 15s 超时 | 离线模式，每 30s 重试一次，不阻塞 UI |
| 云端超时 | 15s 无首包 | 提示“网络开小差”，重试 2 次 |
| API 401/403 | HTTP 状态码 | 提示检查 API Key，跳转设置 |
| API 429 | HTTP 状态码 | 提示“请求太频繁”，退避 30s |
| 音频欠载 | 环形缓冲低于 1 帧 | 插入静音，记录日志，不崩溃 |
| 内存不足 | `heap_caps_get_free_size` 低于阈值 | 停止动画/释放缓存；仍低则切回 factory |
| WebSocket 断开 | 心跳超时 | 指数退避重连（1s/2s/4s，最多 30s） |
| 看门狗 | 任务超时 | 保存状态 → 重启；连续 3 次则回 factory |

---

## 3. 游戏子系统（ota_0）

游戏子系统负责：Retro-Go 启动器、NES 模拟器、ROM 加载、画面/音频输出、存档与退出。

### 3.1 启动与选游戏

```mermaid
flowchart TD
    S(["复位进入 ota_0"]) --> B["初始化 LCD / 按键 / 音频 / SD"]
    B --> C["挂载 SD 卡"]
    C --> D{"SD 挂载成功？"}
    D -->|"否"| E["提示：未检测到 SD 卡"]
    E --> C
    D -->|"是"| F["扫描 /roms/nes 目录"]
    F --> G{"找到 ROM？"}
    G -->|"否"| H["提示：拷贝 .nes 文件到 /roms/nes"]
    H --> F
    G -->|"是"| I["显示游戏列表<br/>标题 / 文件大小 / 最近游玩"]
    I --> J["选择 ROM"]
    J --> K["加载 ROM 到 PSRAM<br/>校验 iNES header"]
    K --> L{"加载成功？"}
    L -->|"否"| M["提示 ROM 损坏 / 不支持的 mapper"]
    M --> I
    L -->|"是"| N["初始化 nofrendo<br/>CPU / PPU / APU / mapper"]
    N --> O["进入帧循环"]
```

### 3.2 帧循环

```mermaid
flowchart TD
    A["帧循环开始"] --> B["扫描按键 / 手柄输入"]
    B --> C{"长按 START ≥ 1.5 s？"}
    C -->|"是"| D["暂停菜单<br/>继续 / 存档 / 重置 / 退出"]
    C -->|"否"| E["执行一帧<br/>CPU / PPU / APU / mapper"]
    E --> F["RGB565 帧缓冲"]
    F --> G["SPI2 DMA → ST7789"]
    G --> H["音频环形缓冲 → I2S1 → 功放"]
    H --> I["每 1 s 检查电量 / 更新 FPS"]
    I --> J{"掉帧？"}
    J -->|"是"| K["跳帧 1–2 帧 / 降采样"]
    J -->|"否"| L["保持 60 Hz 逻辑 / 30 fps 显示"]
    K --> A
    L --> A
    D -->|"继续"| A
    D -->|"存档并退出"| M["保存 SRAM / 状态到 SD"]
    M --> N["切 factory → 重启"]
```

> NES 逻辑帧率是 60Hz（NTSC）。ESP32-S3 上首版目标“稳定 30fps 显示 + 60Hz 逻辑”，即每显示一帧跑两次逻辑，或开启跳帧。性能富余时再冲 60fps。

### 3.3 存档与退出

| 动作 | 实现 |
|---|---|
| 即时存档 | 保存 CPU/PPU/APU 寄存器 + RAM + mapper 状态到 SD |
| 电池存档 | 保存 SRAM 到 `.sav` 文件，退出/切游戏时写回 |
| 退出到主系统 | 先 `fsync` 存档，再 `esp_ota_set_boot_partition(factory)` + `esp_restart()` |
| 异常退出 | 看门狗重启后进入游戏列表，不自动加载上次 ROM，避免坏档循环 |

### 3.4 性能策略

| 瓶颈 | 策略 |
|---|---|
| PPU 渲染 | 只渲染可见扫描线；帧缓冲放 PSRAM，DMA 用内部 RAM bounce buffer |
| SPI 刷屏 | 40–80MHz，DMA 双缓冲；一帧分 2–4 块传输，避免长时间占用总线 |
| 音频 | APU 输出环形缓冲 2–3 帧；I2S DMA 中断填充，禁止在中断里做重活 |
| 输入 | 10ms 扫描 + 20ms 消抖；组合键在应用层识别 |
| 跳帧 | 根据 `esp_timer` 实测帧耗时动态跳 0–2 帧 |
| ROM 加载 | 整块读入 PSRAM；避免运行时反复读 SD |

---

## 4. 三子系统共用的按键约定

| 场景 | 按键 | 行为 |
|---|---|---|
| 全局 | `START + B` 按住 1.5s | 从 AI/游戏切回主系统（主系统内为无操作） |
| 主系统 Launcher | 方向键 | 切换卡片 |
| 主系统 Launcher | A | 进入 |
| 主系统 Launcher | START | 打开菜单 |
| 主系统 任意界面 | B | 返回上一级 |
| 主系统 菜单 | 长按 START | 回到 Launcher |
| AI 系统 | A 短按 | 摸宠物 / 确认 |
| AI 系统 | A 长按 | 语音输入（PTT） |
| AI 系统 | B | 返回 / 取消 |
| AI 系统 | UP / DOWN | 音量 + / − |
| AI 系统 | START | 打开设置（Wi-Fi、API Key、宠物） |
| 游戏系统 | A / B / 方向 | NES 手柄 |
| 游戏系统 | START | 暂停 |
| 游戏系统 | 长按 START 1.5s | 系统菜单（存档/退出） |
| 键盘模式 | 见 [01-系统框图.md](01-系统框图.md) 7.3 节 | HID 输出 |

> 冲突处理：游戏内 `START+B` 可能是游戏组合键，因此游戏系统用“长按 START”而不是 `START+B` 退出；AI 系统没有游戏输入冲突，保留 `START+B`。

---

## 5. 异常处理总表

| 场景 | 影响 | 处理策略 | 负责子系统 |
|---|---|---|---|
| 屏幕初始化失败 | 黑屏 | 重试 3 次；失败则串口打印错误并点亮背光提示 | 全部 |
| 按键卡死 | 无法操作 | 20ms 消抖 + 连续按下超时判定；记录日志 | 全部 |
| SD 卡缺失 | 无 ROM/存档 | 主系统跳过；游戏系统提示；不崩溃 | 主/游戏 |
| Wi-Fi 连接失败 | 无云端 | 离线模式 + 后台重试 | 主/AI |
| 云端超时 | AI 无响应 | 超时提示 + 重试 + 降级到本地宠物 | AI |
| 低电 | 随时关机 | 20% 提醒；3.4V 降载；3.3V 保存并休眠 | 全部 |
| OOM | 崩溃/重启 | 内存水位监控；释放缓存；连续 OOM 切 factory | 全部 |
| 看门狗 | 任务卡死 | 保存状态 → 重启；记录重启原因 | 全部 |
| 固件切换失败 | 停在原系统 | `esp_ota_set_boot_partition` 返回值检查；失败提示 | 主 |
| 充电过流/过放 | 硬件风险 | 充电 IC 自带保护；软件只做提示，不替代硬件保护 | 硬件 |

---

## 6. 联调顺序建议

1. **主系统**：点屏 → 按键 → LVGL 页面 → 电源显示 → BLE HID → Wi-Fi 音频。
2. **游戏系统**：SD 挂载 → ROM 列表 → NES 画面 → 音频 → 存档 → 退出。
3. **AI 系统**：Wi-Fi 配网 → 文本对话 → 语音上行/下行 → 宠物状态机 → 异常降级。
4. **三系统联调**：菜单切换 → `START+B` 返回 → 连续切换 50 次 → 内存/重启原因检查。

> 每完成一个子系统，先在串口打印关键日志（堆水位、FPS、Wi-Fi 状态、I2S 欠载次数），再进入下一个，避免“全部写完一起调”。
