WPxyz-moon/ESP32HandledConsole/docs/系统框图.png

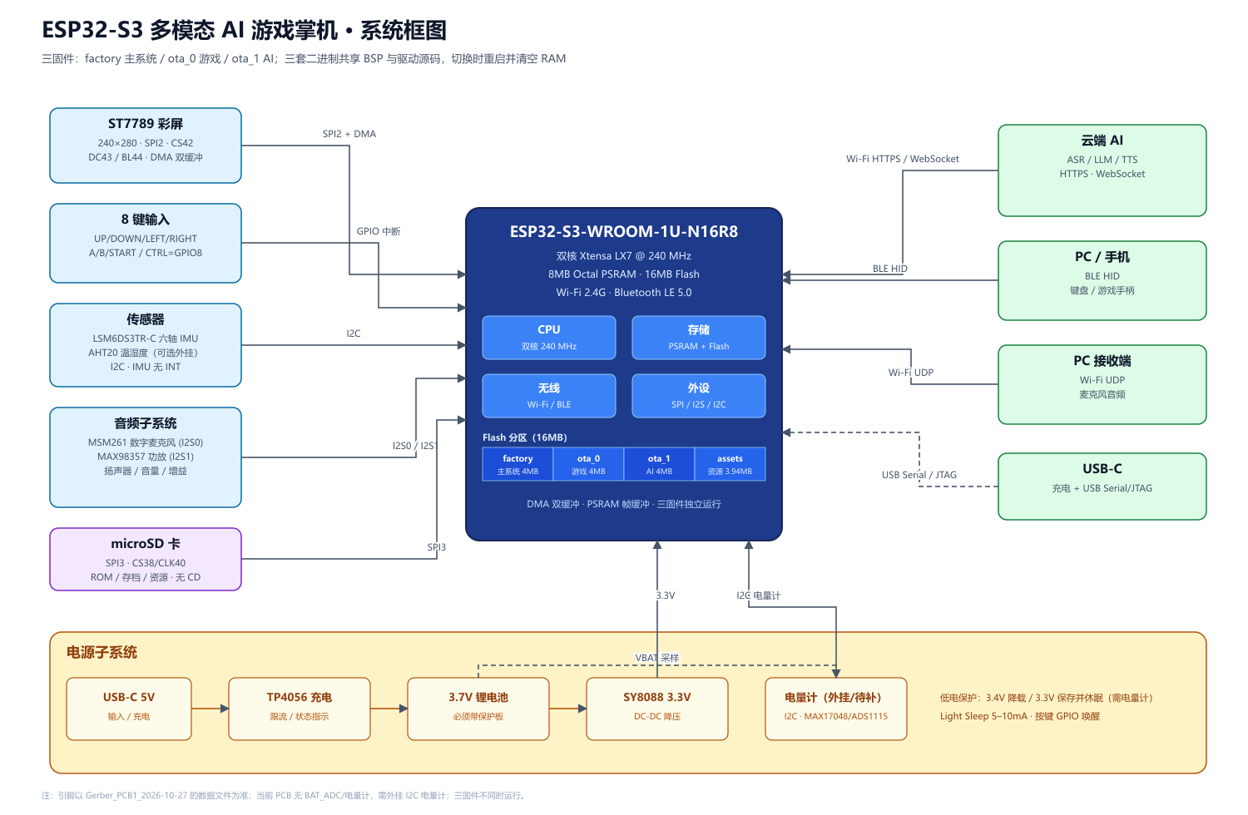
docs/系统框图.png
