WPxyz-moon/ESP32HandledConsole/Gerber_PCB1_2026-10-27/硬件设计参考图.png

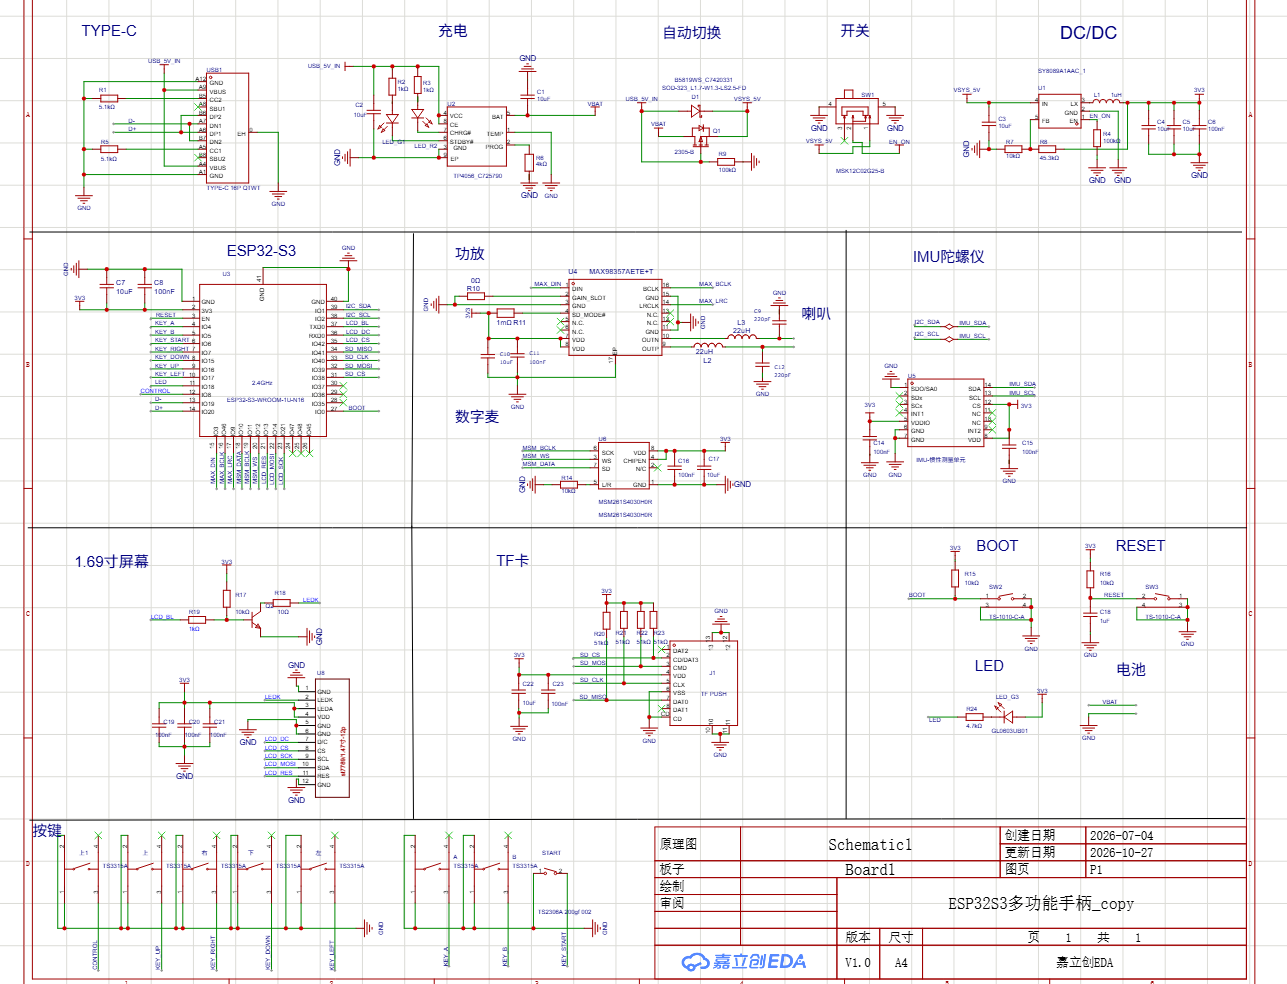
Gerber_PCB1_2026-10-27/硬件设计参考图.png
