WPxyz-moon/ESP32HandledConsole/(commit log)

2026-11-03 更新计划文档
2026-11-03 文档初步完善
    [Drill_NPTH_Through.DRL, Drill_PTH_Through.DRL, Drill_PTH_Through_Via.DRL, Gerber_BoardOutlineLayer.GKO, Gerber_BottomLayer.GBL, Gerber_BottomPasteMaskLayer.GBP, Gerber_BottomSilkscreenLayer.GBO, Gerber_BottomSolderMaskLayer.GBS]
